Roman-RV78/Nalivator/nalivator.JPG

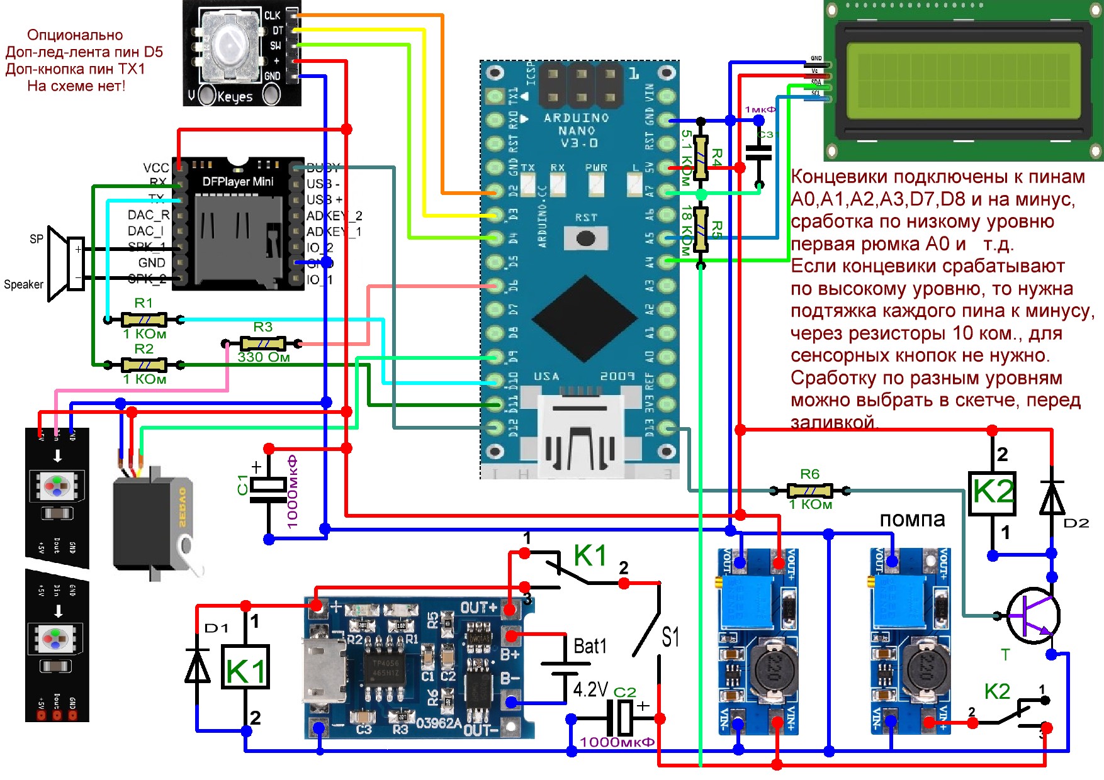
nalivator.JPG
