Roman-RV78/Nalivator/README.md

# Nalivator
https://youtu.be/AGR2if2fc1U

https://youtu.be/1mMaiBXu7Pk

https://youtu.be/p6ojKQy1gjw

https://youtu.be/MbrifMzeDxI
