Roman-RV78/Nalivator/(threads)

Thread 1 (2020-05-30):

не видит стопок при прокачке, калибровке помпы. (буду первым))

ACKET2009, 2020-05-30:
при калибровке помпы все рюмки на местах, но говорит нет рюмок. и при промывке... Уровень датчиков стоит 0

в остальных местах стопки видит, и наливает...

хотя при повторном включении устройства промывка сработала, но потом перешёл на калибровку помпы, рюмку не убирал, соответственно обругалось на это, затем снял и обратно поставил - всё равно, говорит, нет рюмок. затем перевключил устройство, сразу пошёл в калибровку помпы, поставил пустую рюмку - пошла работать помпа.Переставил в другое место - работает. как только повторилась ситуация с отсутствием рюмки, дальше она повторяется независимо от снятия стопок... в скетче версии 3.4 и 3.3 В 3.2 нормально отрабатывает

Roman-RV78, 2020-05-30:
Доброго. Я уже перезалил скетч, исправилОтправлено с моего устройства Huawei-------- Исходное сообщение --------Тема: [Roman-RV78/Nalivator] не видит стопок при прокачке, калибровке помпы. (буду первым)) (#1)От: ACKET2009 Кому: Roman-RV78/Nalivator Копия: Subscribed
при калибровке помпы все рюмки на местах, но говорит нет рюмок. и при промывке... Уровень датчиков стоит 0
в остальных местах стопки видит, и наливает...
хотя при повторном включении устройства промывка сработала, но потом перешёл на калибровку помпы, рюмку не убирал, соответственно обругалось на это, затем снял и обратно поставил - всё равно, говорит, нет рюмок. затем перевключил устройство, сразу пошёл в калибровку помпы, поставил пустую рюмку - пошла работать помпа.Переставил в другое место - работает. как только повторилась ситуация с отсутствием рюмки, дальше она повторяется независимо от снятия стопок... в скетче версии 3.4 и 3.3 В 3.2 нормально отрабатывает

—You are receiving this because you are subscribed to this thread.Reply to this email directly, view it on GitHub, or unsubscribe.
[
{
"@context": "http://schema.org",
"@type": "EmailMessage",
"potentialAction": {
"@type": "ViewAction",
"target": "https://github.com/Roman-RV78/Nalivator/issues/1",
"url": "https://github.com/Roman-RV78/Nalivator/issues/1",
"name": "View Issue"
},
"description": "View this Issue on GitHub",
"publisher": {
"@type": "Organization",
"name": "GitHub",
"url": "https://github.com"
}
}
]

Closed 2020-05-30.

Thread 2 (2020-09-22):

Наливатор

sanyoqq, 2020-09-22:

Roman-RV78, 2020-09-22:
???

sanyoqq, 2020-09-23:
Этот!!!

Отправлено из мобильной Почты Mail.ru

вторник, 22 сентября 2020 г., 18:21 +0200 от notifications@github.com  <notifications@github.com>:
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

Roman-RV78, 2020-11-07:
?

Closed 2020-11-07.

Thread 4 (2023-04-17):

Проблемы при компиляции

SergeyOmskSTB, 2023-04-17:
Компиляция скетча...
"C:\\Users\\Chetverekow\\AppData\\Local\\Arduino15\\packages\\arduino\\tools\\avr-gcc\\7.3.0-atmel3.6.1-arduino7/bin/avr-g++" -c -g -Os -Wall -Wextra -std=gnu++11 -fpermissive -fno-exceptions -ffunction-sections -fdata-sections -fno-threadsafe-statics -Wno-error=narrowing -MMD -flto -mmcu=atmega328p -DF_CPU=16000000L -DARDUINO=10819 -DARDUINO_AVR_NANO -DARDUINO_ARCH_AVR "-IC:\\Users\\Chetverekow\\AppData\\Local\\Arduino15\\packages\\arduino\\hardware\\avr\\1.8.6\\cores\\arduino" "-IC:\\Users\\Chetverekow\\AppData\\Local\\Arduino15\\packages\\arduino\\hardware\\avr\\1.8.6\\variants\\eightanaloginputs" "-IC:\\Users\\Chetverekow\\AppData\\Local\\Arduino15\\packages\\arduino\\hardware\\avr\\1.8.6\\libraries\\EEPROM\\src" "-IC:\\Users\\Chetverekow\\Documents\\Arduino\\libraries\\LCD_1602_RUS-master" "-IC:\\Users\\Chetverekow\\Documents\\Arduino\\libraries\\LiquidCrystal_I2C_V112" "-IC:\\Users\\Chetverekow\\AppData\\Local\\Arduino15\\packages\\arduino\\hardware\\avr\\1.8.6\\libraries\\Wire\\src" "-IC:\\Users\\Chetverekow\\Documents\\Arduino\\libraries\\Adafruit_TiCoServo" "-IC:\\Users\\Chetverekow\\Documents\\Arduino\\libraries\\microLED\\src" "-IC:\\Users\\Chetverekow\\AppData\\Local\\Arduino15\\packages\\arduino\\hardware\\avr\\1.8.6\\libraries\\SoftwareSerial\\src" "-IC:\\Users\\Chetverekow\\Documents\\Arduino\\libraries\\FastLED\\src" "C:\\Users\\CHETVE~1\\AppData\\Local\\Temp\\arduino_build_706068\\sketch\\Nalivator56.ino.cpp" -o "C:\\Users\\CHETVE~1\\AppData\\Local\\Temp\\arduino_build_706068\\sketch\\Nalivator56.ino.cpp.o"
In file included from C:\Users\Chetverekow\Documents\Arduino\libraries\microLED\src/microLED.h:42:0,
                 from D:\Личное\Андруино\Наливатор\Роман\Nalivator-master\Nalivator56\Nalivator56.ino:82:
C:\Users\Chetverekow\Documents\Arduino\libraries\microLED\src/types.h:21:15: error: expected identifier before '=' token
     ORDER_GRB = 0b010010,
               ^
C:\Users\Chetverekow\Documents\Arduino\libraries\microLED\src/types.h:21:15: error: expected '}' before '=' token
C:\Users\Chetverekow\Documents\Arduino\libraries\microLED\src/types.h:21:15: error: expected unqualified-id before '=' token
C:\Users\Chetverekow\Documents\Arduino\libraries\microLED\src/types.h:23:1: error: expected declaration before '}' token
 };
 ^
In file included from D:\Личное\Андруино\Наливатор\Роман\Nalivator-master\Nalivator56\Nalivator56.ino:71:0:
C:\Users\Chetverekow\AppData\Local\Arduino15\packages\arduino\hardware\avr\1.8.6\libraries\EEPROM\src/EEPROM.h:145:20: warning: 'EEPROM' defined but not used [-Wunused-variable]
 static EEPROMClass EEPROM;
                    ^~~~~~

Roman-RV78, 2023-04-17:
Доброго. Никакой кириллицы в путях библиотек, скетчей и тд. и тп. не должно быть.
Судя по всему используется библиотека microLed, не которая здесь находится, а обновлённая, она сильно переработана автором и не работает в данном скетче. Все библиотеки должны строго браться отсюда.

SergeyOmskSTB, 2023-04-18:
Спасибо,попробую 18.04.2023, 00:19, "Roman-RV78" ***@***.***>: Доброго. Никакой кириллицы в путях библиотек, скетчей и тд. и тп. не должно быть.Судя по всему используется библиотека microLed, не которая здесь находится, а обновлённая, она сильно переработана автором и не работает в данном скетче. Все библиотеки должны строго браться отсюда.—Reply to this email directly, view it on GitHub, or unsubscribe.You are receiving this because you authored the thread.Message ID: ***@***.***>  -- С уважениемЧетвереков Сергей Викторовичтел:8-913-680-34-69 (рабочий)тел:8-913-978-24-01 ***@***.***

Closed 2025-03-28.

Thread 5 (2025-03-28):

сбой в работе

A100vba, 2025-03-28:
Добрый день! Собрал по схеме версия 59. Проблема в следующем собрал начал тестить работает. Были проблемы с mp3 плейром - не включал приветствие и тосты, только сервисные звуки. поработал с флешкой появился первый тост. но радость была не долгой. При включении питания грузится, работает 10 сек, выключается подсветка экрана и уже никак не реагирует на энкодер. стал менять поэтапно комплектующие - экран, энкодер, питание, ничего не помогло. Что можно еще проверить?

A100vba, 2025-03-28:
На форуме подсказали - R5 отпаялся у меня и система уходила в сон

Roman-RV78, 2025-03-28:
Доброго. Я видел на форуме, что вопрос решен)))

Closed 2025-03-28.
