Roman-RV78/Nalivator/Nalivator56/c_func.ino

// наливайка, опрос концевиков
void flowTick() {
  if (FLOWdebounce.isReady()) {
    for (uint8_t i = 0; i < NUM_SHOTS; i++) {
      bool swState = !digitalRead(SW_pins[i]) ^ SWITCH_LEVEL;
      if (shotStates[i] == NO_GLASS && swState && readySystem) { // поставили пустую рюмку
        shotStates[i] = EMPTY; // флаг на заправку
#ifdef TWO_PUMPS
#ifndef LED_CHANGE_DIRECTION
        if (pourFrom[i] == 0) strip.setLED(i, mRGB(COLOR_EMPTY_GLASS_1)); // подсветили
        else if (pourFrom[i] == 1) strip.setLED(i, mRGB(COLOR_EMPTY_GLASS_2)); // подсветили
#else
        if (pourFrom[i] == 0)strip.setLED(NUM_SHOTS - 1 - i, mRGB(COLOR_EMPTY_GLASS_1)); // подсветили
        else if (pourFrom[i] == 1)strip.setLED(NUM_SHOTS - 1 - i, mRGB(COLOR_EMPTY_GLASS_2)); // подсветили
#endif
#else
#ifndef LED_CHANGE_DIRECTION
        strip.setLED(i, mRGB(COLOR_EMPTY_GLASS_1));  // подсветили
#else
        strip.setLED(NUM_SHOTS - 1 - i, mRGB(COLOR_EMPTY_GLASS_1));  // подсветили
#endif
#endif
        LEDchanged = true;
        //DEBUG("set glass");
        //DEBUG(i);
        if (!systemON && !save && !playMush)play_track(i + 20); //  трек в папке mp3, с 20 по 25
        yesGlass++;
        SAVEtimer.reset();
        if (save) {
#ifdef SEVE_MODE_CONDITION
          digitalWrite(SEVE_MODE_PIN, HIGH);
          delay(100);
#endif
          play_track(17); // звук просыпания
          save = false;
          enc.rst();
          lcd.backlight();
          check = true; //  проверяем рюмки
          delay(2000);
        }
        if (MenuFlag == 61 && !systemON) {
          oled_naliv();
          systemON = true;

          if (ledShowOn == 1) {
            if (ledShow) check = true;
#ifdef LED_TOWER
            TOWERtimer.setInterval(50);
            if (mig || rainbow ) {
              mig = false;
              rainbow = false;
              clearLed = true;
              TOWERtimer.reset();

            }
#endif
          }

        }
#ifdef TWO_PUMPS
        if (MenuFlag == 20 && yesGlass != 0) kalibr_pump(1);
#endif
      }
      if (shotStates[i] != NO_GLASS && !swState) {   // убрали пустую/полную рюмку
        shotStates[i] = NO_GLASS;                    // статус - нет рюмки
        if (!ledShow) {
#ifndef LED_CHANGE_DIRECTION
          strip.setLED(i, mRGB(COLOR_EMPTY_SPACE));  // чёрный или на выбор
#else
          strip.setLED(NUM_SHOTS - 1 - i, mRGB(COLOR_EMPTY_SPACE));  // чёрный или на выбор
#endif
          LEDchanged = true;
        }
        if (i == curPumping ) { // убрали во время заправки!
#ifdef TWO_PUMPS
          if (pourFrom[curPumping] == 0) pump1OFF();          // помпа выкл
          else if (pourFrom[curPumping] == 1) pump2OFF();     // помпа выкл
#else
          pump1OFF();                                          // помпа выкл
#endif                                 // помпу выкл
          moving = false;
          if ( MenuFlag == 20 || promivka ) {
            curPumping = -1;
            systemState = WAIT;                         // режим работы - ждать
            WAITtimer.reset();
          } else {
            systemState = TOOK;                         // режим работы - взял рюмку во время разлива
            PAUSEtimer.setInterval(2000); // время которое нужно для полного проговаривания трека Моргунова
            PAUSEtimer.reset();
            play_track(2); //  трек в папке mp3,  кто то снял рюмку при наливе
          }

        }
        //DEBUG("take glass");
        //DEBUG(i);
        yesGlass--;
#ifdef TWO_PUMPS
        if (MenuFlag == 20 ) kalibr_pump(0);
#endif
      }
    }
  }
  if (systemON) flowRoutnie();  // если активны - ищем рюмки и всё такое
}

// поиск и заливка
void flowRoutnie() {
  switch (systemState) {
    case SEARCH: // если поиск рюмки
      if (!moving) {
        noGlass = true;
        for (int8_t i = 0; i < NUM_SHOTS; i++) {
          if (shotStates[i] == EMPTY && i != curPumping ) {    // поиск рюмки
            if (MenuFlag == 60) {
              for (int8_t j = randomGlass; j < NUM_SHOTS; j++) {
                if (rumka[j] != -1) {
                  randomGlass = j;
                  break;
                }
              }
              if (subMush == 1) {
                if (i == rumka[randomGlass]) {
                  noGlass = false;                           // один за всех
                }
              } else if (subMush == 2) {
                if (i == rumka[randomGlass]) {
                  if (randomGlass < NUM_SHOTS - 1)randomGlass++;
                  noGlass = false;                          // все за одного
                }
              }
            } else {
              noGlass = false;
            }

            if (!noGlass) { //  нашли хоть одну рюмку
#ifdef DOP_SOUND
              if (dopSound) dop_sound();
#endif
#if(SOUND_THEME == 1)
              if ( digitalRead(BUSY_PIN) && !promivka && MenuFlag != 20) {
                play_track(53); //  трек в папке mp3 ,  движения башни танка
              }
#else
              if ((DrinkCount == 0 || digitalRead(BUSY_PIN)) && !promivka && MenuFlag != 20) {
                play_track(18); //  трек в папке mp3 , мелодия во время разлива
              }
#endif
              curPumping = i;                                   // запоминаем выбор
              systemState = MOVING;                             // режим - движение
              shotStates[curPumping] = IN_PROCESS;              // стакан в режиме заполнения
              break;
            }
          }
        }
      }
      if (noGlass) {                                         // если не нашли ни одной рюмки
#if(SOUND_THEME == 1)
        if ( muveBack) {
          play_track(53); //  трек в папке mp3 ,  движения башни танка
          muveBack = false;
        }

#endif
        readySystem = false;
#ifdef STARTING_POS_SERVO_GLASS1
        servo_move(shotPos[0]);                             // цель серво - первая рюмка
#else
        servo_move(0);                                     // цель серво - 0
#endif
        if (!moving) {                                    // едем до упора
          if (DrinkCount > 0 && !promivka && MenuFlag != 20) {
            if ( noTostBarmen == 0 || MenuFlag != 61) {
              PAUSEtimer.setInterval(NALITO_PAUSE);
              oled_nalito(); // Выводим на экран налито ...
              tost = true;
              if (player) {
                playOn = true;
                player = false;
              }
            } else {
              PAUSEtimer.setInterval(100);
              returnMenu = true;
            }
            if (!player && volume != 0 && !digitalRead(BUSY_PIN) ) {
              myMP3.stop();
              delay(100);
              myMP3.setVolume(volume);
            }

            if (ledShowOn == 1) {
              ledShow = true;
              LEDtimer.setInterval(TABLE_RAINBOW_ILLUMINATION_TIMER);
#ifdef LED_TOWER
              TOWERtimer.setInterval(20);
              rainbow = true;
              clearLed = true;
              TOWERtimer.reset();
#endif
            }
          } else {
            PAUSEtimer.setInterval(NALITO_PAUSE);
            lcd.clear();
            if (yesGlass == 0 || promivka || MenuFlag == 20) {
              lcd.setCursor(3, 1);
              print_lcd(5);//  НЕТ РЮМОК!
            } else {
              lcd.setCursor(1, 1);
              print_lcd(6);//  СНИМИТЕ РЮМКИ!
            }
            returnMenu = true;
            play_track(3); //  трек в папке mp3,  типа предупреждение нет рюмок


#ifdef LED_TOWER
            if (ledShowOn == 1) {
              TOWERtimer.setInterval(50);
              mig = true;
              rainbow = false;
              clearLed = true;
              TOWERtimer.reset();
            }
#endif
          }
          DrinkCount = 0;
          systemON = false;
          curPumping = -1; // снимаем выбор рюмки
#if(SOUND_THEME == 1)
          muveBack = true;
#endif
#ifdef DOP_SOUND
          if (dopSound) dopSound = false;
#endif
          //DEBUG("no glass");
          PAUSEtimer.reset();
        }
      }
      break;

    case MOVING: // движение к рюмке
      if (flag) {
        if (!promivka) oled_naliv();
        else menu_promivka(1);
        flag = false;
      }
      servo_move(shotPos[curPumping]);
      if (!moving) {                                        // если приехали
        systemState = PUMPING;                              // режим - наливание
        if (!promivka) {
#ifdef TWO_PUMPS
          if (pourFrom[curPumping] == 0) TIMEProcent.setInterval(time50ml_1 / 50); // перенастроили таймер для первой помпы
          else if (pourFrom[curPumping] == 1) TIMEProcent.setInterval(time50ml_2 / 50); // перенастроили таймер для второй помпы
#else
          TIMEProcent.setInterval(time50ml_1 / 50); // перенастроили таймер для первой помпы
#endif
        }
        else TIMEProcent.setInterval(1);

        Procent = 0;
        TIMEProcent.reset();
#ifdef TWO_PUMPS
        if (pourFrom[curPumping] == 0)  pump1ON();                // НАЛИВАЙ!
        else if (pourFrom[curPumping] == 1)  pump2ON();           // НАЛИВАЙ!
#else
        pump1ON();                                           // НАЛИВАЙ!
#endif
        if (!promivka && MenuFlag != 20) {
          DrinkCount++;
          lcd.setCursor(11, 0);
          if (MenuFlag == 1 || MenuFlag == 60 ) {
            lcd.print(Drink, DEC);
          } else if (MenuFlag == 2) {
            lcd.print(ManDrink[curPumping], DEC);
          } else if (MenuFlag == 61) {
            if (barMan == 1) lcd.print(Drink, DEC);
            else if (barMan == 2)lcd.print(ManDrink[curPumping], DEC);
          }
          lcd.setCursor(2, 1);
          lcd.print((curPumping + 1), DEC);
          lcd.setCursor(11, 1);
          print_lcd(4);//  пробел 3
#if(SOUND_THEME == 1)
          play_track(51);  //выстрел танка
#endif
        }
        //DEBUG("fill glass");
      }
      break;

    case PUMPING: // если качаем
      if (TIMEProcent.isReady()) {
        Procent++;
        if (!promivka) {
          if ((MenuFlag == 1 || MenuFlag == 20 || MenuFlag == 60) && Procent >= Drink) {
            readyDrink = true;
          } else if ( MenuFlag == 2 && Procent >= ManDrink[curPumping]) {
            readyDrink = true;
          } else if ( MenuFlag == 61) {
            if (barMan == 1 && Procent >= Drink) readyDrink = true;
            else if (barMan == 2 && Procent >= ManDrink[curPumping]) readyDrink = true;
          }
          lcd.setCursor(12, 1);
          lcd.print(Procent, DEC);
        } else {
          if ( MenuFlag == 11  && (Procent >= 7000 || !enc.isHold())) readyDrink = true;
#ifdef BUTTON_TOWER
          else if (MenuFlag != 11  && (Procent >= 7000  || !stateBut)) readyDrink = true;
#endif

        }
      }
      if (readyDrink) {  // если налили
#ifdef TWO_PUMPS
        if (pourFrom[curPumping] == 0) pump1OFF();          // помпа выкл
        else if (pourFrom[curPumping] == 1) pump2OFF();     // помпа выкл
#else
        pump1OFF();                                          // помпа выкл
#endif
        shotStates[curPumping] = READY;                     // налитая рюмка, статус: готов
#ifndef LED_CHANGE_DIRECTION
        strip.setLED(curPumping, mRGB(COLOR_POURET_GLASS));             // подсветили
#else
        strip.setLED(NUM_SHOTS - 1 - curPumping, mRGB(COLOR_POURET_GLASS));             // подсветили
#endif
        strip.show();
        curPumping = -1;                                    // снимаем выбор рюмки
        systemState = WAIT;                                 // режим работы - ждать
        WAITtimer.reset();
        readyDrink = false;
        //DEBUG("wait");
      }
      break;

    case WAIT:
      if (WAITtimer.isReady()) {
        systemState = SEARCH;
        //DEBUG("search");
        if (promivka) {
          systemON = false;
          if (MenuFlag == 11) {
            menu_promivka(2);
          } else {
            do {
#ifdef STARTING_POS_SERVO_GLASS1
              servo_move(shotPos[0]);                             // цель серво - первая рюмка
#else
              servo_move(0);                                     // цель серво - 0
#endif
            } while (moving);
            returnMenu = true;
          }
          promivka = false;
        }
        if (MenuFlag == 20) systemON = false;

      }
      break;
    case TOOK:
      if (PAUSEtimer.isReady()) {
        systemState = WAIT;
      }
      break;
  }
}


void servo_move(uint8_t target) {
  static uint32_t prevServoTime = 0;
#ifdef SERVO_CHANGE_DIRECTION
  target = 180 - target;
#endif
#ifdef STARTING_POS_SERVO_GLASS1
#ifdef SERVO_CHANGE_DIRECTION
  static uint8_t pos = INITAL_ANGLE_SERVO - shotPos[0];
#else
  static uint8_t pos = shotPos[0];
#endif
#else
#ifdef SERVO_CHANGE_DIRECTION
  static uint8_t pos = INITAL_ANGLE_SERVO;
#else
  static uint8_t pos = 0;
#endif
#endif
  static bool deadTime = false;
  if (!moving) {
    if (pos != target) {
      moving = true;
      deadTime = false;
      prevServoTime = millis();
#ifdef SERVO_DETACH_PIN_ON
      if (MenuFlag != 41 ) servo.attach(SERVO_PIN, SERVO_MIN, SERVO_MAX);
#endif
    }
  }
  if ( moving && !deadTime && millis() - prevServoTime >= speedSer) {
    prevServoTime = millis();
    if (pos > target) pos--;
    else if (pos < target) pos++;
    servo.write(pos);
    if ( pos == target ) {
      deadTime = true;
#if(SOUND_THEME == 1)
      if (!playMush && !promivka && Menu != SETTINGS) play_track(52); //клик башни
#endif
    }
  }

  if (deadTime && millis() - prevServoTime >= POST_PAUSE) { // пауза после остановки сервы до включения помпы
    deadTime = false;
    moving = false;
#ifdef SERVO_DETACH_PIN_ON
    if (MenuFlag != 41 ) servo.detach();
#endif
  }
}

void energy_saving() {
  if (sleepTime != 0 && !systemON && !tost && !save && SAVEtimer.isReady()) {
    play_track(16);
    lcd.noBacklight();
    save = true;
    strip.clear();
    strip.show();
#ifdef SEVE_MODE_CONDITION
    delay(1000);
    digitalWrite(SEVE_MODE_PIN, LOW);
#endif
  }
}


void ret_menu() {
  if (returnMenu && PAUSEtimer.isReady()) {
    if (MenuFlag == 1 || MenuFlag == 60 ) {
      oled_auto();  // выходим в меню автоналива
    } else if (MenuFlag == 2) {
      multi_naliv();  // выходим в меню мультиналива
    } else if (promivka) {
      menu_promivka(0);
    } else if (MenuFlag == 20) {
      kalibr_pump(0);
    } else if (MenuFlag == 61) {
      if (barMan == 1)oled_auto();
      else if (barMan == 2)multi_naliv();
    }

    returnMenu = false;
    promivka = false;
    readySystem = true;
  }
}

#ifdef BAT_MONITOR_ON
void bat_tery() {
  static uint32_t prevBatTime = 0;
  static uint8_t flagBat = 0;
  static uint8_t flag = 0;
  static int16_t value = 750;
  if (!systemON && !ledShow && !playMush && millis() - prevBatTime >= 1000UL) {
    prevBatTime = millis();
    value = ((value * 4) + analogRead(BAT_PIN) ) / 5;
    v_akky = value * coeff_bat;
    if (v_akky <= 3) { // 3 вольта
      flagBat = 0;
#ifdef LOW_BAT_SLEEP_ON
      if (!lowBat) {
        lowBat = true; // гасим всё
        lcd.noBacklight();
        if (player) {
          playOn = false;
          player = false;
          myMP3.stop();
        }
        strip.clear();
        strip.show();
      }
#endif
    } else if (v_akky <= 3.2) { // 3.2 вольта
      flagBat = 1;
    } else if (v_akky <= 3.4) { // 3,4 вольта
      flagBat = 2;
#ifdef LOW_BAT_SLEEP_ON
      if (lowBat) {
        lowBat = false;
        lcd.backlight();
        check = true; //  проверяем рюмки
      }
#endif
    } else if (v_akky <= 3.6) { // 3,6 вольта
      flagBat = 3;
    } else if (v_akky <= 3.8) { // 3,8 вольта
      flagBat = 4;
    } else if (v_akky <= 4.2) { // 4,2 вольта
      flagBat = 5;
    } else if (v_akky <= 5) { // 5 вольт от сети
      flagBat = 6;
    }
    if (!lowBat && flagBat != flag && (MenuFlag <= 6 || MenuFlag == 60 || MenuFlag == 61)  && !tost  && !returnMenu) {
      flag = flagBat;
      switch (flag) {
        case 0: lcd.createChar(7, battery0); break;
        case 1: lcd.createChar(7, battery1); break;
        case 2: lcd.createChar(7, battery2); break;
        case 3: lcd.createChar(7, battery3); break;
        case 4: lcd.createChar(7, battery4); break;
        case 5: lcd.createChar(7, battery5); break;
        case 6: lcd.createChar(7, power); break;
      }
      lcd.setCursor(15, 0);
      lcd.write(7);
    }
    if (MenuFlag == 18) {
      lcd.setCursor(5, 1);
      lcd.print(v_akky, 2);
    } else if (MenuFlag == 118) {
      lcd.setCursor(6, 0);
      lcd.print(v_akky, 2);
    }
  }
}
#endif
void mix() {
  if (tracks > 0) {
    for (uint8_t i = 0; i < tracks; i++) TostList[i] = i; // заполняем массив тостов, последовательно значениями
    num = 0;
    if (mixTracks == 1 ) {
      randomSeed(CreateTrulyRandomSeed());//  инициализирует генератор псевдослучайных чисел
      for (uint8_t i = tracks - 1; i > 0 ; i--) { // перемешиваем значения случайно в массиве так, что они не повторяются
        uint8_t idx = random( i + 1) ;
        uint8_t t = TostList[i];
        TostList[i] = TostList[idx];
        TostList[idx] = t;
      }
    }
  }
}

void mix_music() {
  if (tracks2 > 0) {
    for (uint8_t i = 0; i < tracks2; i++) MusicList[i] = i; // заполняем массив песенок, последовательно значениями
    if (mixMusic == 1 ) {
      randomSeed(CreateTrulyRandomSeed());//  инициализирует генератор псевдослучайных чисел
      for (uint8_t i = tracks2 - 1; i > 0 ; i--) { // перемешиваем значения случайно в массиве так, что они не повторяются
        uint8_t idx = random( i + 1) ;
        uint8_t t = MusicList[i];
        MusicList[i] = MusicList[idx];
        MusicList[idx] = t;
      }
    }
  }
}

void play_next() {
  if (player && !pause && PLAYtimer.isReady() && !nextTrack  ) {
    if (digitalRead(BUSY_PIN)) {
      if (playOn) {
        playOn = false;
      }
      nextTrack = true;
      num2++;
    }
  }
  if (nextTrack) {
    PLAYtimer.reset();
    nextTrack = false;
    pause = false;
    oldNum = num2;
    if (num2 <= tracks2 - 1) {
      myMP3.playFolderTrack(folder2, (MusicList[num2] + 1));
      if (!player) {
        player = true;
        if ( MenuFlag == 3) menu_play(0);
      } else {
        if ( MenuFlag == 3) menu_play(4);
      }
    } else {
      player = false;
      num2 = 0;
      myMP3.stop();
      delay(100);
      if ( MenuFlag == 3) menu_play(0);
      myMP3.setVolume(volume);
    }

  }
}

void print_lcd (const uint8_t n) {
  static char buf[32];
  strcpy_P(buf, (char*)pgm_read_word(&(text[n])));
  lcd.print(buf);
}


#ifdef BUTTON_TOWER
void button_tower () {
  static uint32_t butTowTime = 0;
  static uint8_t clickCount = 0;
  static bool lastStateBut = false;
  static bool flagDubl = false;
  if ((MenuFlag == 1 || MenuFlag == 2 || MenuFlag == 60 ) && ((!systemON  && !returnMenu && !save && !playMush && MenuFlag != 61) || promivka))  {
    stateBut = digitalRead(BUT_TOWER_PIN);
    if (stateBut != lastStateBut ) {
      lastStateBut = stateBut;
      if (!lastStateBut) {
        if (tost) {
          noTost = true;
        } else {
          clickCount++;
          butTowTime = millis();
          flagDubl = true;
        }
      }

    }
    if (flagDubl &&  millis() - butTowTime >= 400) { // двойной клик на башне
      flagDubl = false;
      if (clickCount >= 2) {
        if (MenuFlag != 60) {
#ifdef DOP_SOUND
          if (MenuFlag == 1) dopSound = true;
#endif
          systemON = true;
          flag = true;
          if (noDoliv >= 1) readySystem = false;
          if (ledShowOn == 1) {
            if (ledShow) check = true;
#ifdef LED_TOWER
            TOWERtimer.setInterval(50);
            if (mig || rainbow ) {
              mig = false;
              rainbow = false;
              clearLed = true;
              TOWERtimer.reset();

            }
#endif
          }
        } else if (MenuFlag == 60) {
          flagMush = true;
        }
        SAVEtimer.reset();
      }
      clickCount = 0;
    }
  }
}
#endif



void play_track(uint8_t tr) {
  if (!player && volume != 0 ) myMP3.playMp3FolderTrack(tr);
}

#ifdef DOP_SOUND
void dop_sound() {
  if (!player && volume != 0 && digitalRead(BUSY_PIN)) {
    if (Drink <= 20) myMP3.playMp3FolderTrack(30);
    else if (Drink <= 30) myMP3.playMp3FolderTrack(31);
    else if (Drink <= 35) myMP3.playMp3FolderTrack(32);
    else if (Drink <= 40) myMP3.playMp3FolderTrack(33);
    else if (Drink <= 45) myMP3.playMp3FolderTrack(34);
    else if (Drink <= 50) myMP3.playMp3FolderTrack(35);
    delay(500);
    while ( !digitalRead(BUSY_PIN))
      delay(500);
  }
  dopSound = false;
}
#endif

void play_mushket() {
  static bool muveServo = false;
  static uint8_t countRand = 0;
  if (flagMush) {
    flagMush = false;
    countRand = 0;
    for (uint8_t i = 0; i < NUM_SHOTS; i++) {
      if (shotStates[i] == EMPTY ) countRand++; // подсчёт стопок готовых к наливу
      rumka[i] = i; // заполняем массив последовательно позициями  рюмок
    }
    if (countRand != 0) {
      playMush = true;
      if (volume != 0 ) {
        if (ledShowOn == 1) {
          ledShow = true;
          LEDtimer.setInterval(TABLE_RAINBOW_ILLUMINATION_TIMER);
#ifdef LED_TOWER
          TOWERtimer.setInterval(20);
          rainbow = true;
#endif
        }

        if (player) {
          playOn = true;
          player = false;
          myMP3.stop();
          delay(100);
        }
        myMP3.setVolume(volume);
        delay(100);
        myMP3.playMp3FolderTrack(15); // 0015 трек в папке MP3, рулетка
        lcd.clear();
        lcd.setCursor(2, 0);
        print_lcd(75);//  КРУЧУ ВЕРЧУ
        lcd.setCursor(2, 1);
        print_lcd(76);//  НАЛИТЬ ХОЧУ
#ifndef PLAYER_MH2024K_24SS
        delay(500);
#else
        delay(1000);
#endif
      }
    } else {
      systemON = true;
    }
  }

  if (playMush) {
    if (!muveServo) {
      servo_move(shotPos[NUM_SHOTS - 1]);
      if (!moving) muveServo = true;
    } else {
      servo_move(shotPos[0]);
      if (!moving) muveServo = false;
    }
    if ( digitalRead(BUSY_PIN) || player) {
      moving = false;
      muveServo = false;
      systemON = true;
      flag = true; // флаг ,если пустые рюмки найдены показываем меню налива
      readySystem = false;
      countRand = 0;
      randomSeed(CreateTrulyRandomSeed());
      for (int8_t i = NUM_SHOTS - 1 ; i >= 0; i--) {
        int8_t idx = random( i + 1) ;
        int8_t t = rumka[i];
        rumka[i] = rumka[idx];
        rumka[idx] = t;
        if (shotStates[i] == EMPTY ) countRand++; // снова подсчёт стопок готовых к наливу, вдруг кто снял во время трека рулетки
      }
      //randomGlass = random(countRand);
      randomGlass = 1;
      for (uint8_t i = 0; i < NUM_SHOTS; i++) {
        if (shotStates[rumka[i]] != EMPTY )rumka[i] = -1; // убираем позиции из разлива, где нет тары
        if (countRand > 1 && subMush == 2) {
          if ( i == randomGlass && rumka[i] == -1) randomGlass++;
          else if ( i == randomGlass ) rumka[i] = -1; // убираем из разлива одну из установленных рюмок
        }
      }
      playMush = false;
      randomGlass = 0;
      if (ledShowOn == 1) {
        if (ledShow) check = true;
        LEDtimer.setInterval(GLASS_RAINBOW_ILLUMINATION_TIMER);
#ifdef LED_TOWER
        TOWERtimer.setInterval(50);
        if (mig || rainbow ) {
          mig = false;
          rainbow = false;
          clearLed = true;
          TOWERtimer.reset();

        }
#endif
      }
    }
  }
}

void move_enc(uint8_t* var, int16_t shift, int16_t lowLimit, int16_t upLimit, bool cycle) {
  int16_t value = (int16_t) * var;
  value += shift;
  if (value > upLimit) value = (cycle) ? lowLimit : upLimit ;
  if (value < lowLimit) value = (cycle) ? upLimit : lowLimit;
  *var = (uint8_t)value;
}



void move_enc(int16_t* var, int16_t shift, int16_t lowLimit, int16_t upLimit, bool cycle) {
  *var += shift;
  if (*var > upLimit) *var = (cycle) ? lowLimit : upLimit;
  if (*var < lowLimit) *var = (cycle) ? upLimit : lowLimit ;
}
