Roman-RV78/Nalivator/Nalivator56/menu2.h

const char string_0[] PROGMEM = "НУ,";
const char string_1[] PROGMEM = "НАА-ЧАА-ЛИИИИ!";
const char string_2[] PROGMEM = "ТРЕК -  ";
const char string_3[] PROGMEM = "!!! ТОСТ !!!";
const char string_4[] PROGMEM = "   ";
const char string_5[] PROGMEM = "НЕТ РЮМОК!";
const char string_6[] PROGMEM = "СНИМИТЕ РЮМКИ!";
const char string_7[] PROGMEM = "НАЛИВАТОР+";
const char string_8[] PROGMEM = "НАЛИТЬ ПОРОВНУ";
const char string_9[] PROGMEM = "МУЛЬТИРАЗЛИВ";
const char string_10[] PROGMEM = "ПЛЕЕР";
const char string_11[] PROGMEM = "НАСТРОЙКИ";
const char string_12[] PROGMEM = "ПРОМЫВКА";
const char string_13[] PROGMEM = "ТОСТЫ";
const char string_14[] PROGMEM = "МЕНЮ  СЕРВО";
const char string_15[] PROGMEM = "ЯРКОСТЬ  LED";
const char string_16[] PROGMEM = "БАРМЕН";
const char string_17[] PROGMEM = "НАПРЯЖЕНИЕ АКБ";
const char string_18[] PROGMEM = "ТАЙМЕР СНА";
const char string_19[] PROGMEM = "КАЛИБР.ПОМПЫ";
const char string_20[] PROGMEM = "HАЛИTЬ";
const char string_21[] PROGMEM = "HИ O ЧEM";
const char string_22[] PROGMEM = "ПO ЧУTЬ - ЧУTЬ";
const char string_23[] PROGMEM = "B CAMЫЙ PAЗ";
const char string_24[] PROGMEM = "ПО  ПОЛНОЙ";
const char string_25[] PROGMEM = "ДО КРАЕВ";
const char string_26[] PROGMEM = "НАЛИВАЮ     ml";
const char string_27[] PROGMEM = "В  -Ю РЮМКУ   ml";
const char string_28[] PROGMEM = "HАЛИТО";
const char string_29[] PROGMEM = "ПО    ml";
const char string_30[] PROGMEM = "   В   РЮМ";
const char string_31[] PROGMEM = "КУ     ";
const char string_32[] PROGMEM = "КИ     ";
const char string_33[] PROGMEM = "ОК     ";
const char string_34[] PROGMEM = "-я рюмка";
const char string_35[] PROGMEM = "поз.:";
const char string_36[] PROGMEM = "1-   2-   3-";
const char string_37[] PROGMEM = "4-   5-   6-";
const char string_38[] PROGMEM = "B";
const char string_39[] PROGMEM = "-Я РЮМКА:   ml ";
const char string_40[] PROGMEM = "ГР.ОЗВУЧКИ";
const char string_41[] PROGMEM = "ПЕРЕМЕШАТЬ ТРЕКИ";
const char string_42[] PROGMEM = "ПАПКА С ТРЕКАМИ";
const char string_43[] PROGMEM = "ДИР:";
const char string_44[] PROGMEM = "ТРЕКОВ:";
const char string_45[] PROGMEM = "НЕТ";
const char string_46[] PROGMEM = "PLAY";
const char string_47[] PROGMEM = "НАСТРОЙКИ  СЕРВО";
const char string_48[] PROGMEM = "КАЛИБРОВКА";
const char string_49[] PROGMEM = "СКОРОСТЬ";
const char string_50[] PROGMEM = "ГРОМКОСТЬ";
const char string_51[] PROGMEM = "ЯРКОСТЬ";
const char string_52[] PROGMEM = "П Р О М Ы В К А";
const char string_53[] PROGMEM = ">>>>>>>>>>>>";
const char string_54[] PROGMEM = "ВКЛ. ";
const char string_55[] PROGMEM = "ВЫКЛ.";
const char string_56[] PROGMEM = "НАПРЯЖЕНИЕ";
const char string_57[] PROGMEM = "V";
const char string_58[] PROGMEM = "ЗАСНУТЬ ЧЕРЕЗ";
const char string_59[] PROGMEM = ".30";
const char string_60[] PROGMEM = ".00";
const char string_61[] PROGMEM = "МИН.";
const char string_62[] PROGMEM = "НАЛИВ 50ml ЗА:";
const char string_63[] PROGMEM = "мс";
const char string_64[] PROGMEM = "  ml";
const char string_65[] PROGMEM = "<";
const char string_66[] PROGMEM = ">";
const char string_67[] PROGMEM = "ГР:";
const char string_68[] PROGMEM = "ТР:";
const char string_69[] PROGMEM = "SHOW";
const char string_70[] PROGMEM = "ОТБОЙ!";
const char string_71[] PROGMEM = "МУШКЕТЕРЫ";
const char string_72[] PROGMEM = "ОДИН ЗА ВСЕХ";
const char string_73[] PROGMEM = "ВСЕ ЗА ОДНОГО";
const char string_74[] PROGMEM = "M";
const char string_75[] PROGMEM = "КРУЧУ  ВЕРЧУ";
const char string_76[] PROGMEM = "НАЛИТЬ  ХОЧУ";
const char string_77[] PROGMEM = "ДОЛИВ";
const char string_78[] PROGMEM = "*"; // лень убирать, будет резерв на строку
const char string_79[] PROGMEM = " ";
const char string_80[] PROGMEM = "R";
const char string_81[] PROGMEM = "L";
#ifdef TWO_PUMPS
const char string_82[] PROGMEM = "1";
const char string_83[] PROGMEM = "2";
const char string_84[] PROGMEM = "=";
#endif


const char *const text[] PROGMEM  = {
  string_0, string_1, string_2, string_3,
  string_4, string_5, string_6, string_7,
  string_8, string_9, string_10, string_11,
  string_12, string_13, string_14, string_15,
  string_16, string_17, string_18, string_19,
  string_20, string_21, string_22, string_23,
  string_24, string_25, string_26, string_27,
  string_28, string_29, string_30, string_31,
  string_32, string_33, string_34, string_35,
  string_36, string_37, string_38, string_39,
  string_40, string_41, string_42, string_43,
  string_44, string_45, string_46, string_47,
  string_48, string_49, string_50, string_51,
  string_52, string_53, string_54, string_55,
  string_56, string_57, string_58, string_59,
  string_60, string_61, string_62, string_63,
  string_64, string_65, string_66, string_67,
  string_68, string_69, string_70, string_71,
  string_72, string_73, string_74, string_75,
  string_76, string_77, string_78, string_79,
  string_80, string_81
#ifdef TWO_PUMPS
  , string_82, string_83, string_84
#endif
};
