Roman-RV78/Nalivator/Nalivator56/random.h

#include <avr/interrupt.h>
#include <avr/wdt.h>
#include <util/atomic.h>
#define randomSeed(s) srandom(s)
 
volatile uint32_t seed;
volatile int8_t nrot;    
 
uint32_t CreateTrulyRandomSeed()
{
  seed = 0;
  nrot = 32; 
  
  cli();                                             
  MCUSR = 0;                                         
  _WD_CONTROL_REG |= (1<<_WD_CHANGE_BIT) | (1<<WDE); 
  _WD_CONTROL_REG = (1<<WDIE);                       
  sei();                                             
 
  while (nrot > 0); 
  cli();                                             
  MCUSR = 0;                                         
  _WD_CONTROL_REG |= (1<<_WD_CHANGE_BIT) | (0<<WDE); 
  _WD_CONTROL_REG = (0<< WDIE);                      
  sei(); 
  return seed;                                            
}
 
ISR(WDT_vect)
{
  nrot--;
  seed = seed << 8;
  seed = seed ^ TCNT1L;
}
