Roman-RV78/Nalivator/положить библиотеки куда следует/LightweightServo-master/examples/TwoServos/TwoServos.ino

/*
 *  TwoServos.cpp
 *  Moves 2 servos attached at pin 9 and 10 using the LightweightServo library.
 *
 *
 *  Copyright (C) 2018  Armin Joachimsmeyer
 *  armin.joachimsmeyer@gmail.com
 *
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
 */

#include <Arduino.h>

#include "LightweightServo.h"

#define VERSION_EXAMPLE "1.0"

void setup() {
    Serial.begin(115200);
    while (!Serial); //delay for Leonardo
    // Just to know which program is running on my Arduino
    Serial.println(F("START " __FILE__ "\r\nVersion " VERSION_EXAMPLE " from " __DATE__));
    // no initialization needed for LightweightServo :-)
}

void loop() {
    /*
     * Let the servo at pin 9 swipe from 0 to 180 and back to 90 degree
     */
    write9(0);
    delay(1500);
    write9(180);
    delay(1000);
    write9(90);
    delay(1000);

    /*
     * Now move servo at pin 10
     */
    write10(0);
    delay(1500);
    write10(180);
    delay(1000);
    write10(90);
    delay(1000);

    /*
     * Move both servos to 45 degree using microseconds as parameter
     */
    Serial.print("45 degree = ");
    Serial.print(MicrosecondsToDegreeLightweightServo(45));
    Serial.println(" micro seconds");
    writeMicroseconds9(1008);
    writeMicroseconds10(1008);
    delay(5000);
}
