Roman-RV78/Nalivator/(commit log)

2020-05-29 Update Организация флешки и микро инструкция.txt
2020-05-30 upd
    Исправлен косяк с отсутствием рюмок при промывке и калибровке серво. Добавлена возможность на этапе компиляции выбрать, начальную позицию разливного крана на первой рюмке.
    [a_setup.ino, c_func.ino, d_control.ino]
2020-05-31 upd
    При установке рюмок на места, добавлен сброс таймера сна, чтобы наливатор не засыпал в этот момент.
2020-05-31 add
    Нашел в нете какой то генератор случайных чисел, тем самым освобождаем аналоговый пин от участия в рандоме. Рандом стал более случайным. НУЖНО ПРОБОВАТЬ))))
2020-05-31 upd
    Исправлен баг с отсутствием рюмок, при включении опции бармен.
    [c_func.ino, d_control.ino]
2020-06-01 upd
    Исправлен баг с иллюминацией в мушкетёрах при нулевой громкости.
    [c_func.ino]
2020-06-01 add
    Добавлено движение разливного крана туды-сюды, при проигрывании трека рулетки в мушкетёрах.
2020-06-01 upd
    Поправлен баг с отсутствием приветствия при запуске , куда то пропал delay)))
2020-06-02 add
    Только для arduino mega 2560!
2020-06-03 upd
    Убрал лишние для меги дефайны
2020-06-07 ТЕСТ. Выбор рандомно( не по порядку) позиции для налива в мушкетёрах
2020-06-12 Бегушие огни на допледленте при розливе
2020-06-15 upd
    небольшая оптимизация кода. обновлён код под мегу до 38
2020-06-15 upd
    Небольшая оптимизация кода
2020-06-24 upd
    На тест. Возможно исправится косяк в мушкетёрах, иногда наливались все рюмки, а должна одна быть не налита.
    [c_func.ino]
2020-06-27 upd
    Поправил версию модифицированной библиотеки плеера, чтобы не просила обновление. Урезал библиотеку microLED , скетчи только 38 и выше!
2020-06-27 upd
    Правка ошибок, много перелопачено, может появились новые ошибки)))
2020-07-03 upd
    Удалены не актуальные скетчи
2020-07-12 upd
    Добавил возможность выбора уровня сигнала для помпы
2020-07-13 UPD
    Скетч для нано и мега универсальный
2020-08-04 upd
    рандом в плеере
2020-08-08 upd
    Исправление мелких ошибок
    [c_func.ino, d_control.ino]
2020-09-06 upd
    Выбор режима бармен теперь сохраняемый
2020-09-12 Танкистам посвящается
    Добавлена звуковая тема для любителей танков. Выбирается настройкой в скетче
2020-09-30 Реверс серво
    Добавлен режим смены направления движения серво.
2020-09-30 upd
    Добавлена смена движения серво, если физически перевёрнуто
2020-10-04 Реверс серво в коде без переделки схемы
2020-10-23 upd
    Добавлена корректировка углов серво, исправлены ошибки русского языка))). Чёто с кодом ещё мудрил)))
    [a_setup.ino, b_loop.ino, c_func.ino, d_control.ino, e_menu.ino, encUniversalMinim.h, f_ilumination.ino, menu2.h]
2020-11-03 UPD
    Раздельное зеркалирование серво, пинов и led диодов
2020-11-06 upd
    не сохранялись высокие скорости серво, исправлено
    [a_setup.ino, d_control.ino]
2020-11-08 upd
    Убрал использование лишних пинов, если выбрано меньше 6 рюмок
2020-11-09 upd
    исправление ошибок при зеркале серво
    [a_setup.ino, d_control.ino]
2021-01-27 upd
    Выход в настройки мультиразлива тройным кликом энкодера, когда находимся в мультиразливе
2021-03-04 upd
    Добавлена настройка минимального объёма тары
2021-03-27 upd
    Добавил настройку цвета статусов установленных налитых-пустых рюмок
2021-04-06 Create Мануал по железу Nalivator.pdf
2021-04-06 Любезно предоставлено Змий
2021-06-10 бармен без тостов
    В режиме бармен не произносятся тосты и нет задержек между разливами
2021-08-07 upd
    Добавлен сохраняемый параметр бермен без тостов, чего-то намудрил с иллюминацией стола после налива и иллюминацией налива стопки
2021-08-29 upd
    Добавлен пин состояния спящего режима
2021-09-04 upd
    Добавлены настройки иллюминации стола и налива рюмки
2021-10-08 upd
    Сменена библиотека плеера, можно выбрать в настройках чип плеера
2021-10-09 upd
    Добавлен настраиваемый параметр таймаута ожидания данных с порта
2021-10-09 upd
    Ещё подкорректированный скетч для плеера
2021-10-10 upd
    некоторые исправления
2021-10-11 upd
    Программная подтяжка пина BUSY, на всякий случай
2021-10-16 upd
    посылка плееру трёх команд за раз
2021-10-22 upd
    Добавлена вторая помпа для второго напитка. На тест
2021-10-23 upd
    Обновил инструкцию для двухпомпового варианта
2021-10-23 upd
    Дополнил инструкцию для двух помп
2021-12-02 upd
    Добавлены дополнительные звуки перед автоналивом
2021-12-09 upd
    исправлен баг с проверкой громкости тостов
    [d_control.ino]
2021-12-13 upd
    не проговаривались допзвуки при наливе через допкнопку
2021-12-15 upd
    Возможно исправлен косяк с зависанием, при активных допзвуках
    [c_func.ino]
2021-12-19 UPD
    Перенес режим бармена в основное меню
2021-12-21 upd
    Добавлен быстрый вызов промывки тройным кликом из главного меню
2021-12-25 upd
    Исправлен косяк с допкнопкой в мушкетёрах
    [c_func.ino]
2022-01-15 upd
    Исправлено недоговаривание трека Моргунова, добавлен параметр #define NALITO_PAUSE 3000UL // время показа меню налито, после розлива. Исправлены мелкие ошибки
    [c_func.ino, d_control.ino, tost.ino]
2022-02-05 upd
    Добавлена калибровка АКБ тройным кликом, в меню просмотра напряжения АКБ
2022-02-08 upd
    Исправлен косяк с чтением float и eeprom
    [a_setup.ino]
2022-02-22 upd
    исправление ошибок
2022-02-26 upd
    Добавил настройки очерёдности главного меню, мелкое исправление ошибок
    [Nalivator56.ino, c_func.ino, d_control.ino, e_menu.ino]
2022-03-06 upd
    Небольшие правки
2022-03-07 upd
    Параметр включения иллюминации теперь сохраняемый
2022-03-10 upd
    Проба добавить поддержку тормознутого плеера на чипе MH2024K-24SS. Мелкие правки ещё)))
2022-03-12 upd
    Добавлен параметр отключения генерации сигнала на пине серво, в простое и между наливами в рюмку наливатора
2022-03-12 upd
    восстановлены настройки по умолчанию
2022-05-18 upd
    Добавлен параметр выставления цвета подсветки пустого места, когда рюмка не установлена, по умолчанию чёрный
