Roman-RV78/Nalivator/(notices)

Notices in the files:
положить библиотеки куда следует/LightweightServo-master/examples/TwoServos/TwoServos.ino:
along with this program. If not, see <http://www.gnu.org/licenses/gpl.html>.
Nalivator56/z_DFMiniMp3.h:
DFMiniMp3 is free software: you can redistribute it and/or modify
it under the terms of the GNU Lesser General Public License as
published by the Free Software Foundation, either version 3 of
the License, or (at your option) any later version.
положить библиотеки куда следует/LightweightServo-master/README.md:
License: GPL v3
